kschamplin/picotronix/pcb/picotronix.kicad_pcb

## KiCad design pcb/picotronix.kicad_pcb (2022-04-01)

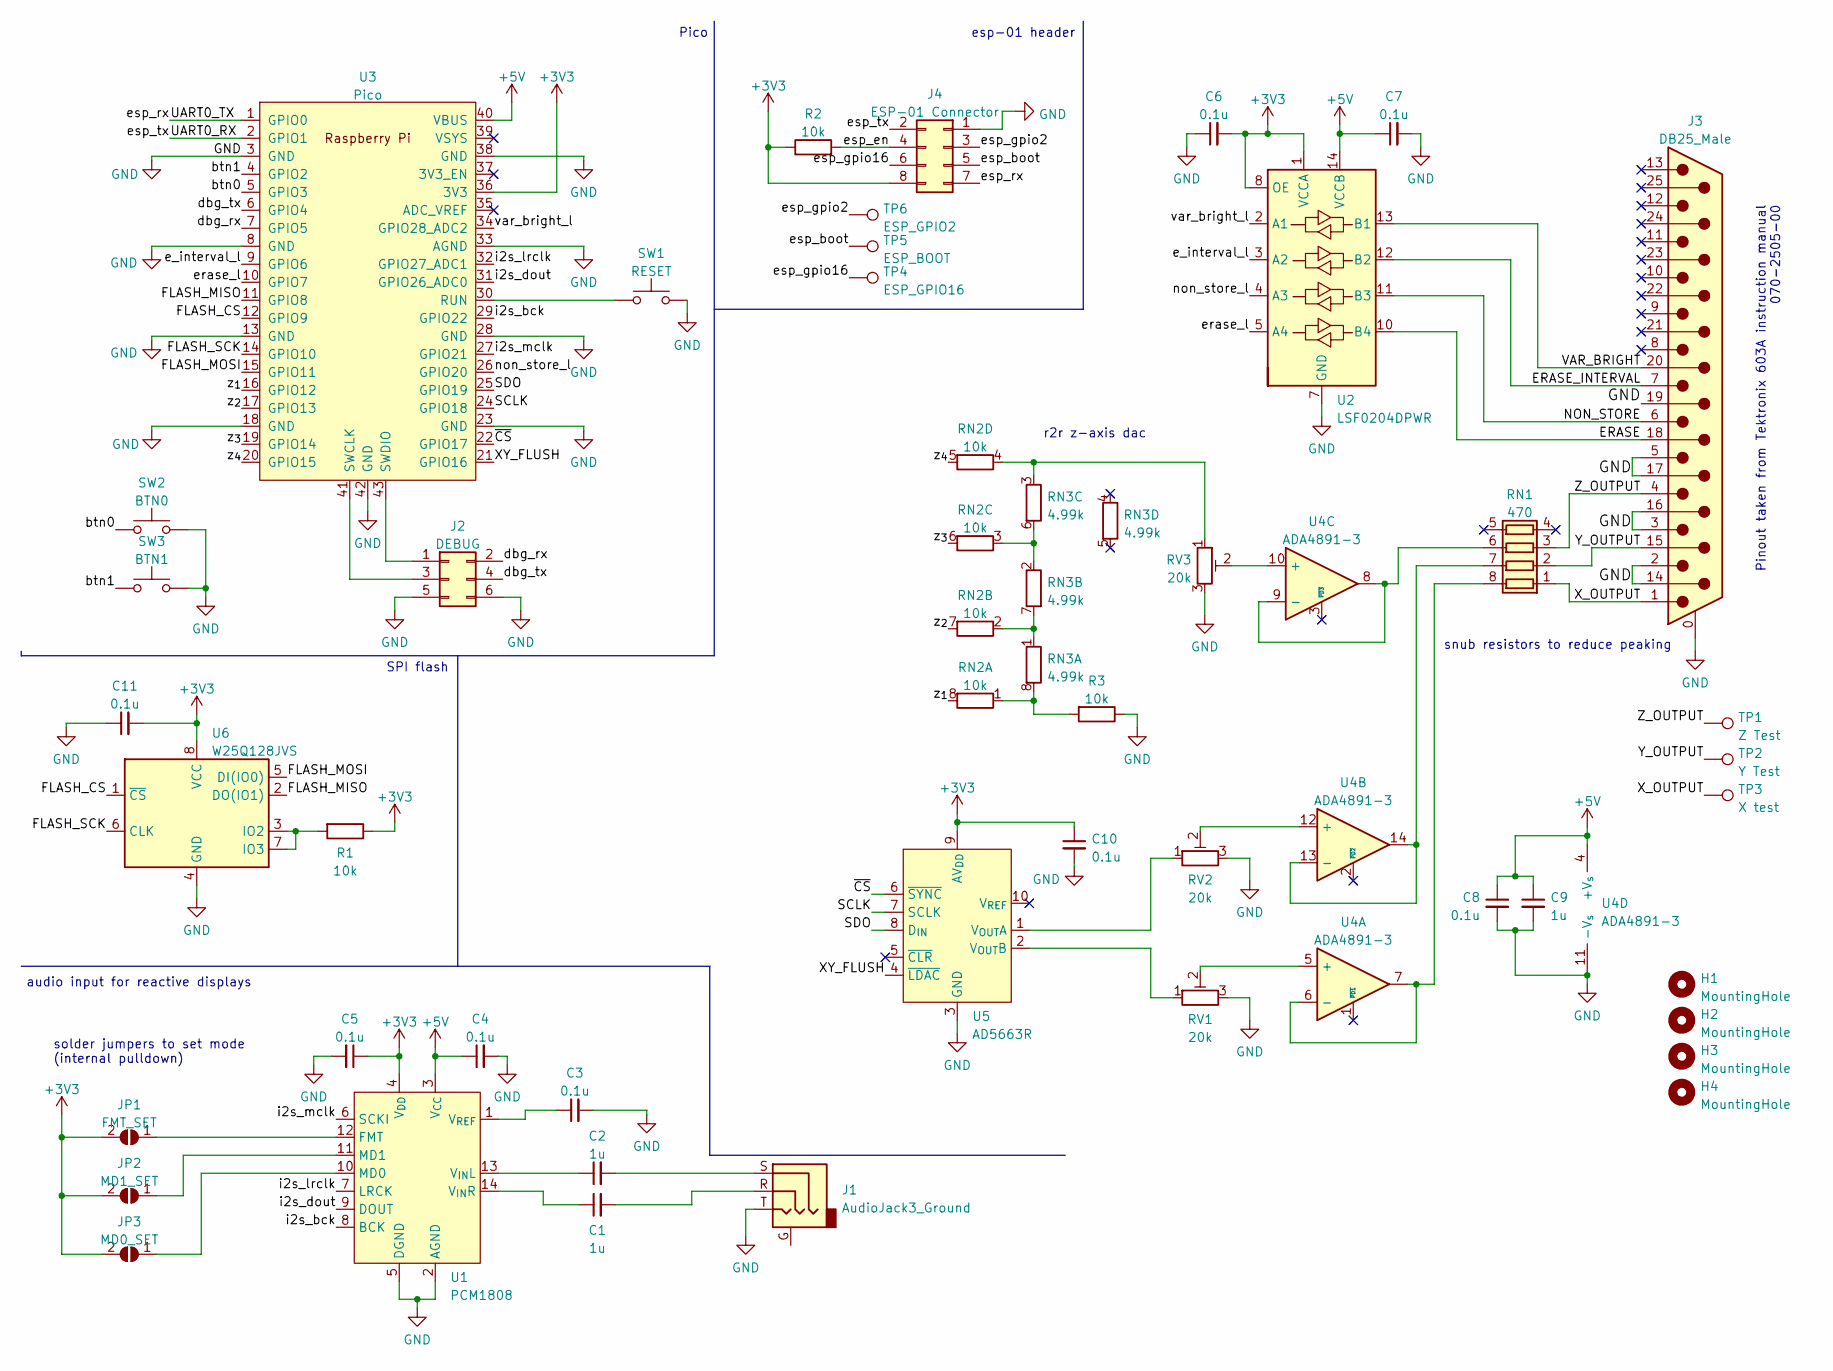
[picture p1: schematic picotronix.kicad_sch, Picotronix Main Board]

Parts:
C1, C2, C9: 1u; C_0603_1608Metric_Pad1.08x0.95mm_HandSolder; Digikey_PN 1276-1102-1-ND
C3, C4, C5, C6, C7, C8, C10, C11: 0.1u; C_0603_1608Metric_Pad1.08x0.95mm_HandSolder; Digikey_PN 1276-CL10B104KB8NNNLCT-ND
H1, H2, H3, H4: MountingHole; MountingHole_3.2mm_M3
J1: AudioJack3_Ground; Jack_3.5mm_CUI_SJ-3524-SMT_Horizontal; Digikey_PN CP-3524SJCT-ND
J2: DEBUG; PinHeader_2x03_P2.54mm_Vertical; Digikey_PN S2011EC-03-ND
J3: DB25_Male; DSUB-25_Male_Horizontal_P2.77x2.84mm_EdgePinOffset9.90mm_Ho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; Digikey_PN AE10982-ND
J4: ESP-01 Connector; PinSocket_2x04_P2.54mm_Vertical; Digikey_PN S7107-ND
JP1: FMT_SET; SolderJumper-2_P1.3mm_Open_TrianglePad1.0x1.5mm
JP2: MD1_SET; SolderJumper-2_P1.3mm_Open_TrianglePad1.0x1.5mm
JP3: MD0_SET; SolderJumper-2_P1.3mm_Open_TrianglePad1.0x1.5mm
R1, R2, R3: 10k; R_0603_1608Metric_Pad0.98x0.95mm_HandSolder; Digikey_PN RNCP0603FTD10K0CT-ND
RN1: 470; R_Array_Convex_4x1206; Digikey_PN CAY16-4700F4LFCT-ND
RN2: 10k; R_Array_Convex_4x1206; Digikey_PN CAY16-1002F4LFCT-ND
RN3: 4.99k; R_Array_Convex_4x1206; Digikey_PN CAY16-4991F4LFCT-ND
RV1, RV2, RV3: 20k; Potentiometer_Bourns_TC33X_Vertical; Digikey_PN TC33X-2-203ECT-ND
SW1: RESET; SW_SPST_TL3305A; Digikey_PN EG5353CT-ND
SW2: BTN0; SW_SPST_TL3305A; Digikey_PN EG5353CT-ND
SW3: BTN1; SW_SPST_TL3305A; Digikey_PN EG5353CT-ND
TP1: Z Test; TestPoint_Pad_D1.0mm
TP2: Y Test; TestPoint_Pad_D1.0mm
TP3: X test; TestPoint_Pad_D1.0mm
TP4: ESP_GPIO16; TestPoint_Pad_D1.0mm
TP5: ESP_BOOT; TestPoint_Pad_D1.0mm
TP6: ESP_GPIO2; TestPoint_Pad_D1.0mm
U1: PCM1808; TSSOP-14_4.4x5mm_P0.65mm; Digikey_PN 296-19773-ND
U2: LSF0204DPWR; TSSOP-14_4.4x5mm_P0.65mm; Digikey_PN 296-40400-1-ND
U3: Pico; RPi_Pico_SMD_TH; Digikey_PN 2648-SC0915CT-ND
U4: ADA4891-3; TSSOP-14_4.4x5mm_P0.65mm; Digikey_PN ADA4891-3WARUZ-R7CT-ND
U5: AD5663R; MSOP-10_3x3mm_P0.5mm; Digikey_PN 505-AD5623RBRMZ-5-ND
U6: W25Q128JVS; SOIC-8_5.23x5.23mm_P1.27mm; Digikey_PN W25Q128JVSIM-ND

Connections:
+3V3: C5.1, C6.2, C10.1, C11.2, J4.8, JP1.2 (B), JP2.2 (B), JP3.2 (B), R1.1, R2.1, U1.4 (V_{DD}), U2.1 (VCCA), U2.8 (OE), U3.36 (3V3), U5.9 (AV_{DD}), U6.8 (VCC)
+5V: C4.1, C7.1, C8.1, C9.1, U1.3 (V_{CC}), U2.14 (VCCB), U3.40 (VBUS), U4.4 (+V_{s})
/ERASE: J3.18, U2.10 (B4)
/ERASE_INTERVAL: J3.7, U2.12 (B2)
/FLASH_CS: U3.12 (GPIO9), U6.1 (~CS)
/FLASH_MISO: U3.11 (GPIO8), U6.2 (DO(IO1))
/FLASH_MOSI: U3.15 (GPIO11), U6.5 (DI(IO0))
/FLASH_SCK: U3.14 (GPIO10), U6.6 (CLK)
/NON_STORE: J3.6, U2.11 (B3)
/SCLK: U3.24 (GPIO18), U5.7 (SCLK)
/SDO: U3.25 (GPIO19), U5.8 (D_{IN})
/UART0_RX: J4.2, U3.2 (GPIO1)
/UART0_TX: J4.7, U3.1 (GPIO0)
/VAR_BRIGHT: J3.20, U2.13 (B1)
/XY_FLUSH: U3.21 (GPIO16), U5.4 (~LDAC)
/X_OUTPUT: J3.1, RN1.1 (R1.1), TP3.1
/Y_OUTPUT: J3.15, RN1.2 (R2.1), TP2.1
/Z_OUTPUT: J3.4, RN1.3 (R3.1), TP1.1
/btn0: SW2.1, U3.5 (GPIO3)
/btn1: SW3.1, U3.4 (GPIO2)
/dbg_rx: J2.2, U3.7 (GPIO5)
/dbg_tx: J2.4, U3.6 (GPIO4)
/e_interval_l: U2.3 (A2), U3.9 (GPIO6)
/erase_l: U2.5 (A4), U3.10 (GPIO7)
/esp_boot: J4.5, TP5.1
/esp_en: J4.4, R2.2
/esp_gpio2: J4.3, TP6.1
/esp_gpio16: J4.6, TP4.1
/i2s_bck: U1.8 (BCK), U3.29 (GPIO22)
/i2s_dout: U1.9 (DOUT), U3.31 (GPIO26_ADC0)
/i2s_lrclk: U1.7 (LRCK), U3.32 (GPIO27_ADC1)
/i2s_mclk: U1.6 (SCKI), U3.27 (GPIO21)
/non_store_l: U2.4 (A3), U3.26 (GPIO20)
/var_bright_l: U2.2 (A1), U3.34 (GPIO28_ADC2)
/z_{1}: RN2.8 (R1.2), U3.16 (GPIO12)
/z_{2}: RN2.7 (R2.2), U3.17 (GPIO13)
/z_{3}: RN2.6 (R3.2), U3.19 (GPIO14)
/z_{4}: RN2.5 (R4.2), U3.20 (GPIO15)
/~CS: U3.22 (GPIO17), U5.6 (~SYNC)
GND: C3.2, C4.2, C5.2, C6.1, C7.2, C8.2, C9.2, C10.2, C11.1, J1.T, J2.5, J2.6, J3.0 (PAD), J3.2, J3.3, J3.5, J3.14, J3.16, J3.17, J3.19, J4.1, R3.1, RV1.3, RV2.3, RV3.3, SW1.2, SW2.2, SW3.2, U1.2 (AGND), U1.5 (DGND), U2.7 (GND), U3.3 (GND), U3.8 (GND), U3.13 (GND), U3.18 (GND), U3.23 (GND), U3.28 (GND), U3.33 (AGND), U3.38 (GND), U3.42 (GND), U4.11 (-V_{s}), U5.3 (GND), U6.4 (GND)
unnamed: C1.1, U1.14 (V_{IN}R)
unnamed: C1.2, J1.R
unnamed: C2.1, U1.13 (V_{IN}L)
unnamed: C2.2, J1.S
unnamed: C3.1, U1.1 (V_{REF})
unnamed: J2.1, U3.43 (SWDIO)
unnamed: J2.3, U3.41 (SWCLK)
unnamed: JP1.1 (A), U1.12 (FMT)
unnamed: JP2.1 (A), U1.11 (MD1)
unnamed: JP3.1 (A), U1.10 (MD0)
unnamed: R1.2, U6.3 (IO2), U6.7 (IO3)
unnamed: R3.2, RN2.1 (R1.1), RN3.8 (R1.2)
unnamed: RN1.6 (R3.2), U4.8, U4.9 (-)
unnamed: RN1.7 (R2.2), U4.13 (-), U4.14
unnamed: RN1.8 (R1.2), U4.6 (-), U4.7
unnamed: RN2.2 (R2.1), RN3.1 (R1.1), RN3.7 (R2.2)
unnamed: RN2.3 (R3.1), RN3.2 (R2.1), RN3.6 (R3.2)
unnamed: RN2.4 (R4.1), RN3.3 (R3.1), RV3.1
unnamed: RV1.1, U5.2 (V_{OUT}B)
unnamed: RV1.2, U4.5 (+)
unnamed: RV2.1, U5.1 (V_{OUT}A)
unnamed: RV2.2, U4.12 (+)
unnamed: RV3.2, U4.10 (+)
unnamed: SW1.1, U3.30 (RUN)

Notes on the sheet:
Pico
solder jumpers to set mode (internal pulldown)
esp-01 header
r2r z-axis dac
audio input for reactive displays
Pinout taken from Tektronix 603A instruction manual 070-2505-00
snub resistors to reduce peaking
SPI flash

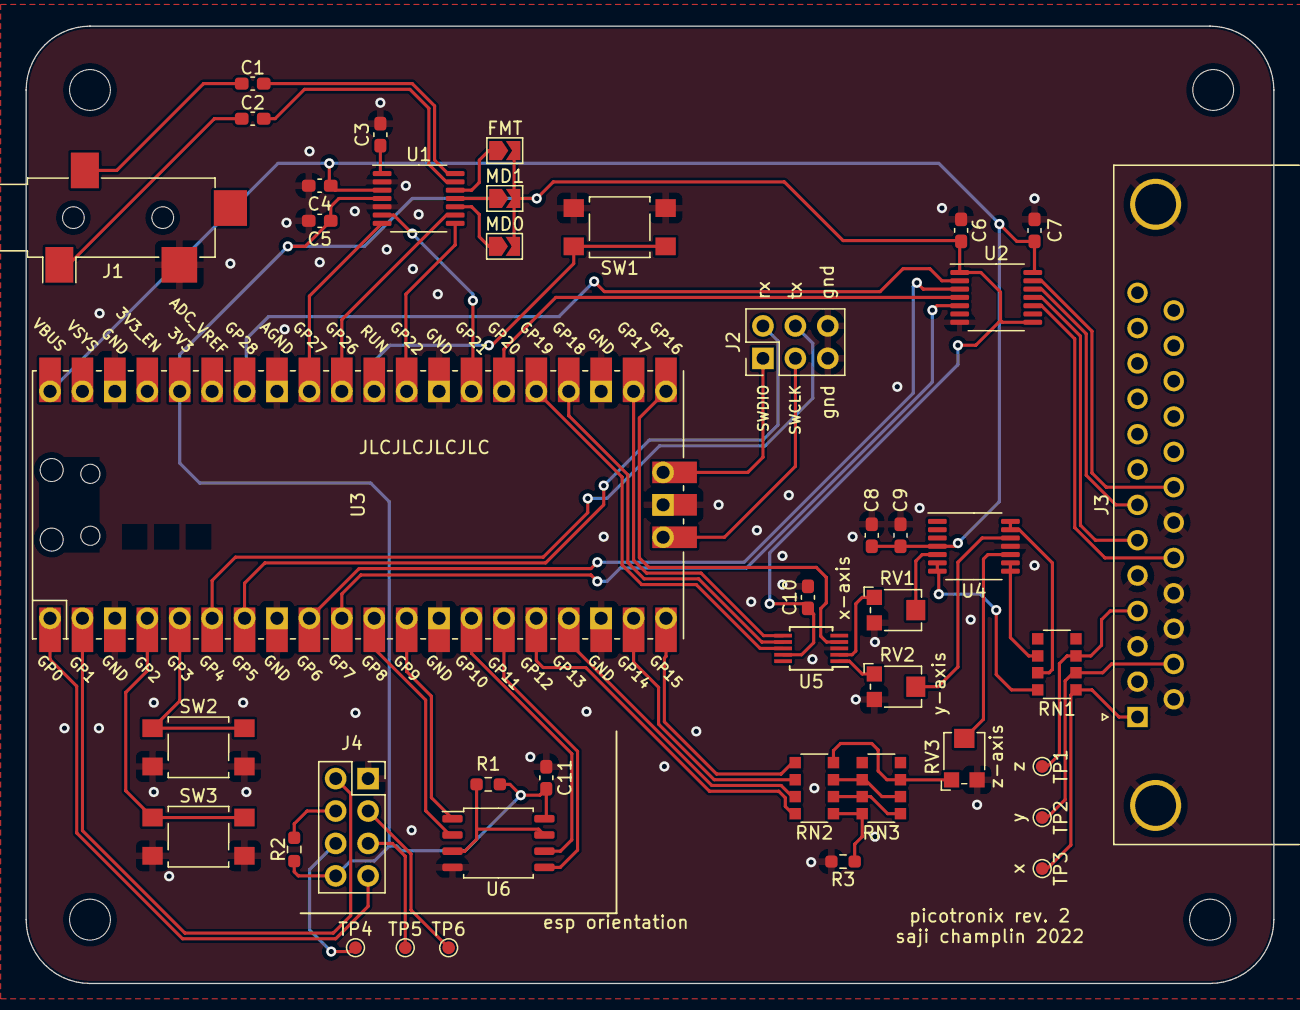
[picture p2: board picotronix.kicad_pcb from above]

Board: 2 copper layers, 97.8 x 75.0 mm, 46 parts (0 on the bottom side), 64 nets.
