kschamplin/picotronix/(commit log)

2022-03-13 finish rev 1
    [picotronix.kicad_pcb, picotronix.kicad_sch]
2022-03-16 move pcb to subdirectory
    [picotronix.kicad_pcb, picotronix.kicad_sch]
2022-03-19 added pico sdk and test programs
2022-03-19 update pcb
    [picotronix.kicad_sch]
2022-03-24 pcb rev2 routed
    [picotronix.kicad_pcb, picotronix.kicad_sch]
2022-03-27 pcb final revision
    [picotronix.kicad_pcb, picotronix.kicad_sch]
2022-03-29 minor revisions to board and schematic (mostly cleanup)
    [picotronix.kicad_pcb, picotronix.kicad_sch]
2022-04-01 some pcb tweaks (ordered this commit for rev 1)
    [picotronix.kicad_pcb, picotronix.kicad_sch]
